kjconway5/ML-Audio/src/rtl/CIC/README.md

## CIC Deciamator

Since the PDM microphone will be outputting
a high-frequency 1-bit stream and our pro-
posed design will require a 16-bit output at
a sampling rate of 16kHz. We must convert
the pulse-density modulation into pulse-code
modulation(the standard form of digital audio
in hardware). This can be done by reducing the
sampling rate(decimation) and increasing the
word length, the preferred method to do this
is a Cascaded Integrator Comb Filter.
The filter consists of an equal number of in-
tegrator and comb filters alongside a decimator.
This describes a single stage CIC filter, however
we can improve attenuation by increasing the
stages of integrators and comb filters.
For this design we choose the number of
stages to be N = 3, this provides a good spot.
We can analyze this decision by looking at the
z-domain transfer function of
the CIC Filter:\
&emsp; &emsp; $H(z) = [(1-z^(-R)/(1-z^(-1))]^N$

In these equations $M = 1$ and $R = \frac{f_{in}}{f_{out}}$. Additionally,
upon analyzing these equations in MATLAB we
find that the outputted frequencies will have
less gain as the frequencies increases: 

Sized Image

This in turn will cause the higher frequencies bins on
a spectrogram(input to ML model) to be low
and potentially cause issues for ML speech
detection, this is called pass-band droop. To
combat this we can employ compensation FIR
Filters since ”in typical decimation filtering ap-
plication we desire reasonably flat pass band
gain and narrow transition region width per-
formance”.

### IP Usage
This CIC Filter is designed, tested, copyrighted by Alex Forencich.
