kjconway5/ML-Audio/src/rtl/Log-Mel/scripts/mel_filterbank.png

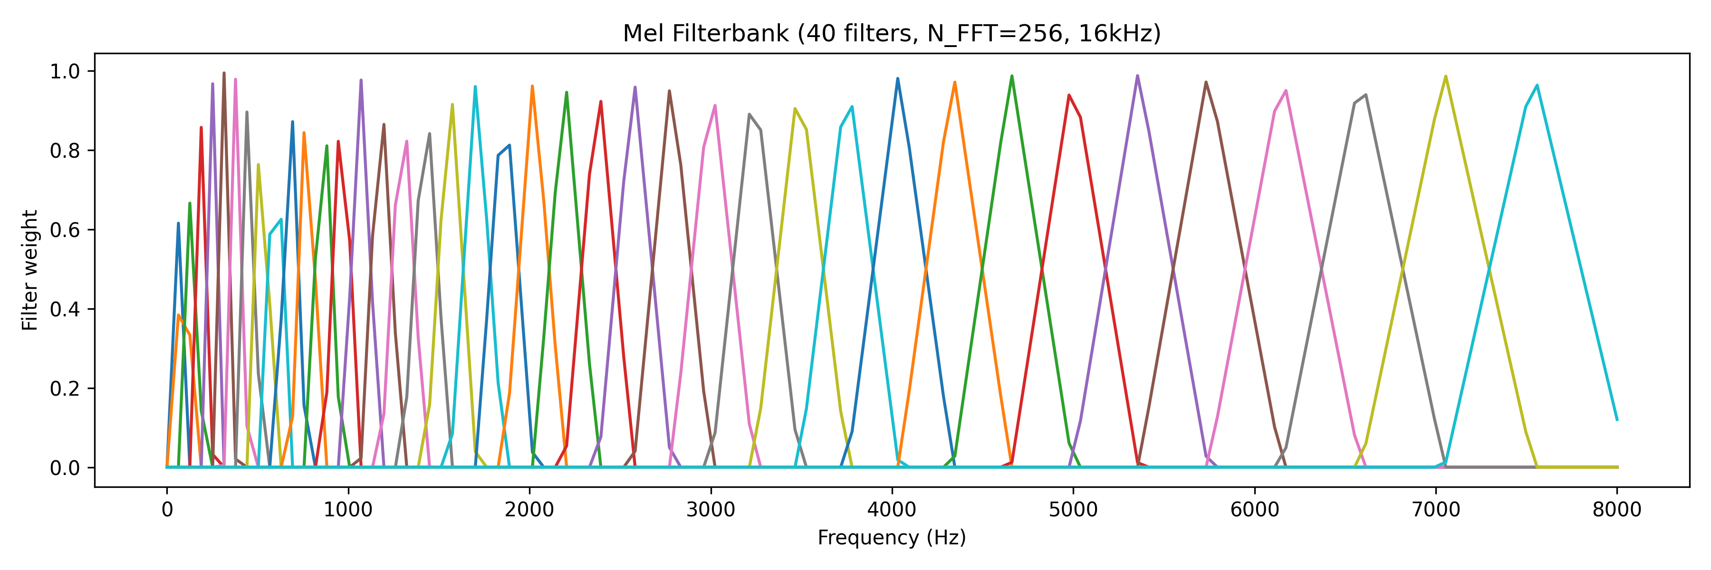
src/rtl/Log-Mel/scripts/mel_filterbank.png
