kjconway5/ML-Audio/src/ml/models/dscnn-16full-v1/sim-core-results.txt

[2026-05-18 14:13:56 PDT] make sim-core
Model: dscnn-16full-v1
Filters: 16
Manifest: /home/dnocera/ML-Audio/src/rtl/dscnn/kws_top/spectrograms/test_vectors.json
Selected sample[9]: f736ab63_nohash_4.wav
WAV: /home/dnocera/ML-Audio/src/ml/Pipeline/speech_commands_v0.02/yes/f736ab63_nohash_4.wav
Hex: spectrograms/spectrogram_9.hex
Golden truth class: yes (6)
Arithmetic class: yes (6)
PyTorch class: yes (6)
RTL class: yes (6)
Expected[manifest arithmetic]: yes (6)
Result: PASS
RTL GAP scores: no(0)=494  off(1)=-789  on(2)=-2415  silence(3)=-2190  unknown(4)=747  wow(5)=150  yes(6)=2204
RTL GAP ranking: yes(6)=2204 > unknown(4)=747 > no(0)=494 > wow(5)=150 > off(1)=-789 > silence(3)=-2190 > on(2)=-2415  margin=1457
