kjconway5/ML-Audio/src/rtl/STFFT/R2FFT/test/1024pt_16bit/result.ods

# vsim work.testbench -c
# Start time: 23:56:48 on Nov 01 | 2016
# Loading sv_std.std
# Loading work.testbench
# Loading work.R2FFT
# Loading work.bitReverseCounter
# Loading work.bfp_bitWidthDetector
# Loading work.bfp_maxBitWidth
# Loading work.bfp_bitWidthAcc
# Loading work.fftAddressGenerator
# Loading work.butterflyUnit
# Loading work.twiddleFactorRomBridge
# Loading work.butterflyCore
# Loading work.bfp_Shifter
# Loading work.ramPipelineBridge
# Loading work.radix2Butterfly
# Loading work.readBusMux
# Loading work.writeBusMux
# Loading work.twrom
# Loading work.dpram
# | input data
# | real part | imag part
# | 0 | 0
# | 1607 | 0
# | 3211 | 0
# | 4808 | 0
# | 6392 | 0
# | 7961 | 0
# | 9512 | 0
# | 11039 | 0
# | 12539 | 0
# | 14010 | 0
# | 15446 | 0
# | 16846 | 0
# | 18204 | 0
# | 19519 | 0
# | 20787 | 0
# | 22005 | 0
# | 23170 | 0
# | 24279 | 0
# | 25330 | 0
# | 26319 | 0
# | 27245 | 0
# | 28106 | 0
# | 28898 | 0
# | 29621 | 0
# | 30273 | 0
# | 30852 | 0
# | 31357 | 0
# | 31785 | 0
# | 32138 | 0
# | 32413 | 0
# | 32610 | 0
# | 32728 | 0
# | 32767 | 0
# | 32728 | 0
# | 32610 | 0
# | 32413 | 0
# | 32138 | 0
# | 31785 | 0
# | 31357 | 0
# | 30852 | 0
# | 30273 | 0
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
