kjconway5/ML-Audio/src/rtl/STFFT/R2FFT/test/256pt_8bit/result.ods

# vsim work.testbench -c
# Start time: 23:53:50 on Nov 01 | 2016
# Loading sv_std.std
# Loading work.testbench
# Loading work.R2FFT
# Loading work.bitReverseCounter
# Loading work.bfp_bitWidthDetector
# Loading work.bfp_maxBitWidth
# Loading work.bfp_bitWidthAcc
# Loading work.fftAddressGenerator
# Loading work.butterflyUnit
# Loading work.twiddleFactorRomBridge
# Loading work.butterflyCore
# Loading work.bfp_Shifter
# Loading work.ramPipelineBridge
# Loading work.radix2Butterfly
# Loading work.readBusMux
# Loading work.writeBusMux
# Loading work.twrom
# Loading work.dpram
# | input data
# | real part | imag part
# | 0 | 0
# | 24 | 0
# | 48 | 0
# | 71 | 0
# | 90 | 0
# | 106 | 0
# | 118 | 0
# | 125 | 0
# | 127 | 0
# | 125 | 0
# | 118 | 0
# | 106 | 0
# | 90 | 0
# | 71 | 0
# | 48 | 0
# | 24 | 0
# | 0 | 0
# | -25 | 0
# | -49 | 0
# | -72 | 0
# | -91 | 0
# | -107 | 0
# | -119 | 0
# | -126 | 0
# | -128 | 0
# | -126 | 0
# | -119 | 0
# | -107 | 0
# | -91 | 0
# | -72 | 0
# | -49 | 0
# | -25 | 0
# | -1 | 0
# | 24 | 0
# | 48 | 0
# | 71 | 0
# | 90 | 0
# | 106 | 0
# | 118 | 0
# | 125 | 0
# | 127 | 0
# | 125 | 0
# | 118 | 0
# | 106 | 0
# | 90 | 0
# | 71 | 0
# | 48 | 0
# | 24 | 0
# | 0 | 0
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
