kjconway5/ML-Audio/src/rtl/STFFT/R2FFT/test/4096pt_24bit/result.ods

# vsim work.testbench -c
# Start time: 23:49:17 on Nov 01 | 2016
# Loading sv_std.std
# Loading work.testbench
# Loading work.R2FFT
# Loading work.bitReverseCounter
# Loading work.bfp_bitWidthDetector
# Loading work.bfp_maxBitWidth
# Loading work.bfp_bitWidthAcc
# Loading work.fftAddressGenerator
# Loading work.butterflyUnit
# Loading work.twiddleFactorRomBridge
# Loading work.butterflyCore
# Loading work.bfp_Shifter
# Loading work.ramPipelineBridge
# Loading work.radix2Butterfly
# Loading work.readBusMux
# Loading work.writeBusMux
# Loading work.twrom
# Loading work.dpram
# | input data
# | real part | imag part
# | 0 | 0
# | 102941 | 0
# | 205866 | 0
# | 308761 | 0
# | 411609 | 0
# | 514395 | 0
# | 617104 | 0
# | 719720 | 0
# | 822227 | 0
# | 924610 | 0
# | 1026855 | 0
# | 1128944 | 0
# | 1230864 | 0
# | 1332598 | 0
# | 1434132 | 0
# | 1535449 | 0
# | 1636536 | 0
# | 1737376 | 0
# | 1837954 | 0
# | 1938255 | 0
# | 2038265 | 0
# | 2137968 | 0
# | 2237348 | 0
# | 2336392 | 0
# | 2435084 | 0
# | 2533409 | 0
# | 2631353 | 0
# | 2728900 | 0
# | 2826036 | 0
# | 2922747 | 0
# | 3019018 | 0
# | 3114834 | 0
# | 3210181 | 0
# | 3305044 | 0
# | 3399410 | 0
# | 3493264 | 0
# | 3586592 | 0
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
