kjconway5/ML-Audio/src/rtl/STFFT/R2FFT/test/ifft/result.ods

# vsim work.testbench -c
# Start time: 23:59:39 on Nov 01 | 2016
# Loading sv_std.std
# Loading work.testbench
# Loading work.R2FFT
# Loading work.bitReverseCounter
# Loading work.bfp_bitWidthDetector
# Loading work.bfp_maxBitWidth
# Loading work.bfp_bitWidthAcc
# Loading work.fftAddressGenerator
# Loading work.butterflyUnit
# Loading work.twiddleFactorRomBridge
# Loading work.butterflyCore
# Loading work.bfp_Shifter
# Loading work.ramPipelineBridge
# Loading work.radix2Butterfly
# Loading work.readBusMux
# Loading work.writeBusMux
# Loading work.twrom
# Loading work.dpram
# | input data
# | real part | imag part
# | 13107 | 0
# | 16034 | -63
# | 18719 | -125
# | 21065 | -188
# | 22985 | -250
# | 24403 | -313
# | 25257 | -375
# | 25501 | -438
# | 25107 | -500
# | 24066 | -563
# | 22390 | -625
# | 20108 | -688
# | 17271 | -750
# | 13944 | -813
# | 10210 | -875
# | 6164 | -937
# | 1911 | -1000
# | -2435 | -1062
# | -6760 | -1125
# | -10947 | -1187
# | -14884 | -1250
# | -18466 | -1312
# | -21599 | -1375
# | -24201 | -1437
# | -26207 | -1500
# | -27568 | -1562
# | -28257 | -1625
# | -28264 | -1687
# | -27600 | -1749
# | -26297 | -1812
# | -24404 | -1874
# | -21987 | -1937
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
