kjconway5/ML-Audio/src/rtl/STFFT/R2FFT/test/small_signal/result.ods

# vsim -voptargs="+acc" work.testbench -c
# Start time: 19:08:45 on Nov 02 | 2016
# Loading sv_std.std
# Loading work.testbench
# Loading work.R2FFT
# Loading work.bitReverseCounter
# Loading work.bfp_bitWidthDetector
# Loading work.bfp_maxBitWidth
# Loading work.bfp_bitWidthAcc
# Loading work.fftAddressGenerator
# Loading work.butterflyUnit
# Loading work.twiddleFactorRomBridge
# Loading work.butterflyCore
# Loading work.bfp_Shifter
# Loading work.ramPipelineBridge
# Loading work.radix2Butterfly
# Loading work.readBusMux
# Loading work.writeBusMux
# Loading work.twrom
# Loading work.dpram
# | input data
# | real part | imag part
# | 3 | 0
# | 4 | 0
# | 1 | 0
# | -3 | 0
# | -5 | 0
# | -3 | 0
# | -1 | 0
# | 0 | 0
# | 0 | 0
# | 2 | 0
# | 4 | 0
# | 2 | 0
# | -2 | 0
# | -5 | 0
# | -4 | 0
# | -1 | 0
# | -1 | 0
# | 0 | 0
# | 1 | 0
# | 3 | 0
# | 3 | 0
# | -1 | 0
# | -4 | 0
# | -4 | 0
# | -2 | 0
# | -1 | 0
# | 0 | 0
# | 1 | 0
# | 3 | 0
# | 4 | 0
# | 1 | 0
# | -3 | 0
# | -5 | 0
# | -3 | 0
# | -1 | 0
# | 0 | 0
# | 0 | 0
# | 2 | 0
# | 4 | 0
# | 2 | 0
# | -2 | 0
# | -5 | 0
# | -4 | 0
# | -1 | 0
# | -1 | 0
# | 0 | 0
# | 1 | 0
# | 4 | 0
# | 3 | 0
# | -1 | 0
# | -4 | 0
# | -4 | 0
# | -2 | 0
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
