kjconway5/ML-Audio/src/rtl/STFFT/R2FFT/test/triple_buffering/result.ods

# vsim work.testbench -c
# Start time: 20:52:23 on Nov 15 | 2016
# Loading sv_std.std
# Loading work.testbench
# Loading work.R2FFT_tribuf
# Loading work.bitReverseCounter
# Loading work.bfp_bitWidthDetector
# Loading work.bfp_maxBitWidth
# Loading work.bfp_bitWidthAcc
# Loading work.fftAddressGenerator
# Loading work.butterflyUnit
# Loading work.twiddleFactorRomBridge
# Loading work.butterflyCore
# Loading work.bfp_Shifter
# Loading work.ramPipelineBridge
# Loading work.radix2Butterfly
# Loading work.readBusMux_tribuf
# Loading work.readBusMux
# Loading work.writeBusMux_tribuf
# Loading work.writeBusMux
# Loading work.twrom
# Loading work.dpram
#
# | FFT Result
# | real part | imag part | ampl | 1st frame | 2nd frame | 3rd frame | 4th frame | 5th frame
# | -1024 | 0 | 1024 | 1024 | 1024 | 1024 | 768 | 512
# | 0 | 0 | 0 | 0 | 0 | 0 | 362.038672 | 0
# | -512 | -512 | 724.077344 | 724.077344 | 0 | 724.077344 | 362.038672 | 286.216701
# | 0 | 0 | 0 | 0 | 0 | 0 | 256 | 0
# | 0 | 0 | 0 | 0 | 724.077344 | 0 | 256 | 0
# | 0 | 0 | 0 | 0 | 0 | 0 | 256 | 0
# | -512 | -512 | 724.077344 | 724.077344 | 0 | 1024 | 0 | 181.019336
# | 0 | 0 | 0 | 0 | 0 | 0 | 256 | 0
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
