kjconway5/ML-Audio/src/rtl/top/full_pipeline_top.sv

module full_pipeline_top #(

    // CIC decimator params
    parameter int CIC_IN_W   = 16,
    parameter int CIC_STAGES = 3,
    parameter int CIC_M      = 1,
    parameter int CIC_RMAX   = 63,
    // Internal accumulator: 16 + ceil(log2(63^3)) = 16 + 18 = 34 bits
    parameter int CIC_REG_W  = CIC_IN_W + $clog2((CIC_RMAX * CIC_M) ** CIC_STAGES),

    // FIR compensation filter params  (runs at 16 kHz)
    parameter int FIR_NTAPS  = 33,
    parameter int FIR_IW     = 18,
    parameter int FIR_CW     = 14,
    parameter int FIR_OW     = 2 * FIR_IW + 5,  // = 37 (full headroom)

    // STFFT params  (16 kHz, 16-bit in / 16-bit per rail out)
    parameter int IW_STFFT   = 16,
    parameter int OW_STFFT   = 16,
    parameter int FFT_SIZE   = 256,
    parameter int FFT_N      = $clog2(FFT_SIZE),
    parameter int HOP        = FFT_SIZE / 2,
    parameter int FIFO_DEPTH = 64,
    parameter FIFO_AW        = $clog2(FIFO_DEPTH),
    parameter int BFP_Q_FRAC = 10,

    // LogMel params
    parameter int IW_LOGMEL  = OW_STFFT,                        // 16
    parameter int SHIFT      = 6,
    parameter int N_MELS     = 40,
    parameter int N_BINS     = 129,
    parameter int MAX_COEFFS = 16,
    parameter int POWER_W    = 2 * IW_LOGMEL - SHIFT + 1 - 1,  // 25
    parameter int WEIGHT_W   = 16,
    parameter int ACCUM_W    = 54,
    parameter int LOG_OUT_W  = 16,
    parameter int LUT_FRAC   = 6,
    parameter int OUT_W      = 16,

    // Spectrogram buffer params
    parameter int SPECT_SHIFT = 9,
    parameter int USE_INPUT_REQUANT = 1,
    parameter int INPUT_QUANT_MULT  = 5805163,
    parameter int INPUT_QUANT_SHIFT = 31,
    parameter int START_FRAME = 37,
    parameter int N_FRAMES    = 50,
    parameter int ADDR_W      = 11
) (
    input  logic clk_i,
    input  logic reset_i,

    // Audio input — 1.008 MHz, 16-bit signed PCM
    input  logic signed [15:0] data_i,
    input  logic               valid_i,
    output logic               ready_o,


    // Spectrogram SRAM ports
    output wire                sp_a_we,
    output wire [ADDR_W-1:0]   sp_a_waddr,
    output wire signed [7:0]   sp_a_wdata,

    output wire                sp_b_we,
    output wire [ADDR_W-1:0]   sp_b_waddr,
    output wire signed [7:0]   sp_b_wdata,

    output logic               spect_done,
    output logic               spect_write_sel,

    output logic [OUT_W-1:0]   mel_compensated_o,
    output logic               mel_compensated_valid_o,

    // VAD threshold (from boot controller)
    input  logic [31:0]        vad_threshold_i,

    // VAD status (active high when speech detected)
    output logic               vad_active_o,

    // DFT / Frame drop
    input  logic                dft_vad_obs_en_i,
    output logic                vad_frame_drop_ol,

    // Flash-load ports for LogMel SRAMs
    input  logic                 flash_mel_coeff_we_i,
    input  logic [7:0]           flash_mel_coeff_addr_i,
    input  logic [15:0]          flash_mel_coeff_data_i,

    input  logic                 flash_mel_index_we_i,
    input  logic [7:0]           flash_mel_index_addr_i,
    input  logic [7:0]           flash_mel_index_data_i,

    input  logic                 flash_log_lut_we_i,
    input  logic [LUT_FRAC-1:0]  flash_log_lut_addr_i,
    input  logic [LOG_OUT_W-1:0] flash_log_lut_data_i,

    // test signals 
    input  logic                   test_mode_audio,

        // cic 
    output logic [CIC_REG_W-1:0]     cic_audio,

        // fir 
    output logic signed [FIR_OW-1:0]    FIR_audio_in,
    output logic signed [FIR_OW-1:0]    FIR_audio_out,

        // spect buff
    output logic [ADDR_W-1:0]      sp_a_waddr_test,
    output logic signed [7:0]      sp_a_wdata_test,

    output logic [ADDR_W-1:0]      sp_b_waddr_test,
    output logic signed [7:0]      sp_b_wdata_test,
    output logic                   spect_write_sel_test,

        // logmel 
    input  logic [7:0]          test_coeff_addr_i,
    input  logic [7:0]          test_index_addr_i,
    input  logic [LUT_FRAC-1:0] test_lut_addr_i,

    output logic [1:0] frame_control_state, 
    output logic [$clog2(N_MELS)-1:0] mel_idx_test,
    output logic [POWER_W:0] power_test


);

// 1.  CIC Decimator — 1.008 MHz → 16 kHz  (ratio 63, 3 stages, M=1)
logic                       stfft_i_ready;  

logic [CIC_REG_W-1:0]  cic_data;   // 34-bit internal accumulator value
logic                  cic_valid;
logic                  cic_ready;
logic                  fir_ready_o;

cic_decimator #(
    .WIDTH    (CIC_IN_W),   // 16
    .RMAX     (CIC_RMAX),   // 63
    .M        (CIC_M),      // 1
    .N        (CIC_STAGES), // 3
    .REG_WIDTH(CIC_REG_W)   // 34
) u_cic (
    .clk           (clk_i),
    .rst           (reset_i),
    .input_tdata   (data_i),
    .input_tvalid  (valid_i),
    .input_tready  (ready_o),
    .output_tdata  (cic_data),
    .output_tvalid (cic_valid),
    .output_tready (fir_ready_o),
    .rate          ($clog2(CIC_RMAX+1)'(CIC_RMAX)),

    // test output 
    .cic_audio     (cic_audio)
);


// 2.  CIC output 

logic signed [15:0] cic_trunc;
logic               cic_trunc_valid;

assign cic_trunc = (cic_data + (1 << 17)) >>> 18; // NOT PARAMITIZED TODO
assign cic_trunc_valid = cic_valid;


// 3.  FIR Compensation Filter

logic [FIR_OW-1:0] fir_result;   // 37-bit full-precision output
logic              fir_valid_o;
logic              fir_ready_i;


compFIR #(
    .NTAPS     (FIR_NTAPS), // 14
    .IW        (FIR_IW),    // 18
    .CW        (FIR_CW),    // 16
    .OW        (FIR_OW)    // 37
) u_fir (
    .i_clk    (clk_i),
    .i_reset  (reset_i),
    .i_tdata  (cic_trunc),
    .i_tvalid (cic_valid),
    .i_tready (fir_ready_o),      
    .o_tdata  (fir_result),
    .o_tvalid (fir_valid_o),
    .o_tready (stfft_i_ready),       

    .FIR_audio_in (FIR_audio_in),
    .FIR_audio_out(FIR_audio_out)
);


// 4.  FIR output 

logic signed [15:0] fir_trunc;
logic               fir_trunc_valid;

assign fir_trunc = (fir_result + (1 << 14)) >>> 15; // NOT PARAMITIZED TODO
assign fir_trunc_valid = fir_valid_o;


// 5.  STFFT — 16 kHz, 16-bit signed input, 32-bit output {re[15:0],im[15:0]}

logic                       stfft_o_valid;
logic [2*OW_STFFT-1:0]      stfft_o_data;
logic                       stfft_o_last;
logic signed [7:0]          bfpexp_raw;

stfft #(
    .IW      (IW_STFFT),
    .OW      (OW_STFFT),
    .FFT_SIZE(FFT_SIZE),
    .HOP     (HOP)
) u_stfft (
    .i_clk    (clk_i),
    .i_reset  (reset_i),

    .i_valid  (fir_valid_o),
    .i_data   (fir_trunc),
    .i_ready  (stfft_i_ready),

    .o_valid  (stfft_o_valid),
    .o_data   (stfft_o_data),
    .o_ready  (1'b1),               // never backpressure the FFT output
    .o_last   (stfft_o_last),
    .o_bfpexp (bfpexp_raw)
);


logic stfft_o_valid_d;
always_ff @(posedge clk_i) begin
    if (reset_i)
        stfft_o_valid_d <= 1'b0;
    else
        stfft_o_valid_d <= stfft_o_valid;
end

// 1-cycle pulse on the FIRST cycle of each frame's output stream.
wire fft_sync_pulse = stfft_o_valid && !stfft_o_valid_d;

// 2. FFT output pipeline registers + 2-cycle delayed sync

logic                       fft_valid_r,  fft_valid_rr;
logic [2*OW_STFFT-1:0]      fft_result_r, fft_result_rr;
logic                       fft_sync_r,   fft_sync_rr;

always_ff @(posedge clk_i) begin
    if (reset_i) begin
        fft_valid_r   <= 1'b0;
        fft_valid_rr  <= 1'b0;
        fft_result_r  <= '0;
        fft_result_rr <= '0;
        fft_sync_r    <= 1'b0;
        fft_sync_rr   <= 1'b0;
    end else begin
        fft_valid_r   <= stfft_o_valid;
        fft_valid_rr  <= fft_valid_r;
        fft_result_r  <= stfft_o_data;
        fft_result_rr <= fft_result_r;
        fft_sync_r    <= fft_sync_pulse;
        fft_sync_rr   <= fft_sync_r;
    end
end

logic signed [OW_STFFT-1:0] fft_re, fft_im;
assign fft_re = fft_result_rr[2*OW_STFFT-1 : OW_STFFT];
assign fft_im = fft_result_rr[OW_STFFT-1   : 0];


// 4. Bin counter — gate fft_valid to the first N_BINS cycles of each frame
//
// bin_cnt_q loads on fft_sync_r (one cycle before fft_result_rr latches
// bin 0), so fft_valid is high for exactly the 129 cycles when bins
// 0..128 sit on fft_result_rr.


localparam int CNT_W = $clog2(N_BINS + 1);
logic [CNT_W-1:0] bin_cnt_q;

always_ff @(posedge clk_i) begin
    if (reset_i)
        bin_cnt_q <= '0;
    else if (fft_sync_r)
        bin_cnt_q <= CNT_W'(N_BINS);
    else if (bin_cnt_q > 0)
        bin_cnt_q <= bin_cnt_q - 1'b1;
end

logic fft_valid;
assign fft_valid = (bin_cnt_q > 0);


// 4. bfpexp latch  (also driven by aligned sync so it updates on the same
//    cycle logmel starts consuming the new frame)

logic signed [7:0] bfpexp_for_mel;

always_ff @(posedge clk_i) begin
    if (reset_i)
        bfpexp_for_mel <= '0;
    else if (fft_sync_r)
        bfpexp_for_mel <= bfpexp_raw;
end

// 5. LogMel (with new VAD port)
logic vad_active;

logic [OUT_W-1:0] mel_data;
logic             mel_valid;
logic             mel_ready;

logmel_top #(
    .IW        (IW_LOGMEL),
    .SHIFT     (SHIFT),
    .N_MELS    (N_MELS),
    .N_BINS    (N_BINS),
    .MAX_COEFFS(MAX_COEFFS),
    .POWER_W   (POWER_W),
    .WEIGHT_W  (WEIGHT_W),
    .ACCUM_W   (ACCUM_W),
    .LOG_OUT_W (LOG_OUT_W),
    .LUT_FRAC  (LUT_FRAC),
    .OUT_W     (OUT_W)
) u_logmel (
    .clk_i                  (clk_i),
    .reset_i                (reset_i),
    .re_il                  (fft_re),
    .im_il                  (fft_im),
    .fft_valid_il           (fft_valid),
    .fft_sync_il            (fft_sync_r),
    .cnn_data_ol            (mel_data),
    .cnn_valid_ol           (mel_valid),
    .cnn_ready_il           (mel_ready),
    .flash_mel_coeff_we_i   (flash_mel_coeff_we_i),
    .flash_mel_coeff_addr_i (flash_mel_coeff_addr_i),
    .flash_mel_coeff_data_i (flash_mel_coeff_data_i),
    .flash_mel_index_we_i   (flash_mel_index_we_i),
    .flash_mel_index_addr_i (flash_mel_index_addr_i),
    .flash_mel_index_data_i (flash_mel_index_data_i),
    .flash_log_lut_we_i     (flash_log_lut_we_i),
    .flash_log_lut_addr_i   (flash_log_lut_addr_i),
    .flash_log_lut_data_i   (flash_log_lut_data_i),
    .vad_threshold_il       (vad_threshold_i),
    .vad_active_ol          (vad_active),
    .dft_vad_obs_en_i       (dft_vad_obs_en_i),
    .vad_frame_drop_ol      (vad_frame_drop_ol),

    // test mode
    .test_mode_i(test_mode_audio),
    .test_coeff_addr_i(test_coeff_addr_i),  
    .test_index_addr_i(test_index_addr_i),
    .test_lut_addr_i(test_lut_addr_i), 
    .mel_idx_test(mel_idx_test),
    .power_test(power_test),
    .frame_control_state(frame_control_state)
);

assign vad_active_o = vad_active;



// 6. bfpexp compensation

localparam int CORR_W = OUT_W + 10;

logic signed [CORR_W-1:0] bfp_correction;
assign bfp_correction = ($signed(bfpexp_for_mel) <<< 1) * (1 << BFP_Q_FRAC);

logic signed [CORR_W-1:0] mel_compensated_wide;
assign mel_compensated_wide = $signed({{(CORR_W-OUT_W){1'b0}}, mel_data})
                            + bfp_correction;

logic [OUT_W-1:0] mel_compensated;
always_comb begin
    if (mel_compensated_wide < 0)
        mel_compensated = '0;
    else if (mel_compensated_wide >= (1 << OUT_W))
        mel_compensated = {OUT_W{1'b1}};
    else
        mel_compensated = mel_compensated_wide[OUT_W-1:0];
end

assign mel_compensated_o       = mel_compensated;
assign mel_compensated_valid_o = mel_valid;


// 7. Spectrogram buffer

spect_buffer_ctrl #(
    .SPECT_SHIFT      (SPECT_SHIFT),
    .USE_INPUT_REQUANT(USE_INPUT_REQUANT),
    .INPUT_QUANT_MULT (INPUT_QUANT_MULT),
    .INPUT_QUANT_SHIFT(INPUT_QUANT_SHIFT),
    .START_FRAME      (START_FRAME),
    .N_MELS           (N_MELS),
    .N_FRAMES         (N_FRAMES),
    .IN_W             (OUT_W),
    .ADDR_W           (ADDR_W)
) u_spect_buf (
    .clk            (clk_i),
    .reset          (reset_i),
    .cnn_data_i     (mel_compensated),
    .cnn_valid_i    (mel_valid),
    .cnn_ready_o    (mel_ready),
    .sp_a_we        (sp_a_we),
    .sp_a_waddr     (sp_a_waddr),
    .sp_a_wdata     (sp_a_wdata),
    .sp_b_we        (sp_b_we),
    .sp_b_waddr     (sp_b_waddr),
    .sp_b_wdata     (sp_b_wdata),
    .spect_done     (spect_done),
    .spect_write_sel(spect_write_sel),

    // test signals 
    .sp_a_waddr_test(sp_a_waddr_test),
    .sp_a_wdata_test(sp_a_wdata_test),
    .sp_b_waddr_test(sp_b_waddr_test),
    .sp_b_wdata_test(sp_b_wdata_test),
    .spect_write_sel_test(spect_write_sel_test),
    .test_mode_audio(test_mode_audio)
);

endmodule
