kjconway5/ML-Audio/src/rtl/CIC/cic.sv

/*

Copyright (c) 2015 Alex Forencich

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
*/

// Language: Verilog 2001

`timescale 1ns / 1ps

/*
 * Cascaded integrator-comb (CIC) Decimator
 */
module cic_decimator #(
    parameter WIDTH = 16,
    parameter RMAX = 2,
    parameter M = 1,
    parameter N = 2,
    parameter REG_WIDTH = WIDTH+$clog2((RMAX*M)**N)
)
(
    input  wire                      clk,
    input  wire                      rst,

    /*
     * AXI stream input
     */
    input  wire [WIDTH-1:0]          input_tdata,
    input  wire                      input_tvalid,
    output wire                      input_tready,

    /*
     * AXI stream output
     */
    output wire [REG_WIDTH-1:0]      output_tdata,
    output wire                      output_tvalid,
    input  wire                      output_tready,

    input logic                      test_mode_audio,
    output logic [REG_WIDTH-1:0]     cic_audio,

    /*
     * Configuration
     */
    input  wire [$clog2(RMAX+1)-1:0] rate
);

/*
 * CIC decimator architecture
 *
 *                       ,---.
 * IN -->(+)--------+--->| V |----+------->(-)--- OUT
 *        ^         |    `---'    |         ^
 *        |         |             |         |
 *        +-- z-1 --+             +-- z-M --+
 *
 *       \___________/           \___________/
 *             N                       N
 *
 *         Integrate    Decimate     Comb
 *
 */

reg [$clog2(RMAX+1)-1:0] cycle_reg = 0;

reg [REG_WIDTH-1:0] int_reg[N-1:0];

wire [REG_WIDTH-1:0] int_reg_0 = int_reg[0];
wire [REG_WIDTH-1:0] int_reg_1 = int_reg[1];

reg [REG_WIDTH-1:0] comb_reg[N-1:0];

wire [REG_WIDTH-1:0] comb_reg_0 = comb_reg[0];
wire [REG_WIDTH-1:0] comb_reg_1 = comb_reg[1];

assign input_tready = output_tready | (cycle_reg != 0);

assign output_tdata = comb_reg[N-1];
assign output_tvalid = input_tvalid & cycle_reg == 0;

genvar k;
// integer i;

// initial begin
//     for (i = 0; i < N; i = i + 1) begin
//         int_reg[i] <= 0;
//         comb_reg[i] <= 0;
//     end
// end

// integrator stages
generate

for (k = 0; k < N; k = k + 1) begin : integrator
    always @(posedge clk) begin
        if (rst) begin
            int_reg[k] <= 0;
        end else begin
            if (input_tready & input_tvalid) begin
                if (k == 0) begin
                    int_reg[k] <= $signed(int_reg[k]) + $signed(input_tdata);
                end else begin
                    int_reg[k] <= $signed(int_reg[k]) + $signed(int_reg[k-1]);
                end
            end
        end
    end
end

endgenerate

// comb stages
generate

for (k = 0; k < N; k = k + 1) begin : comb
    reg [REG_WIDTH-1:0] delay_reg[M-1:0];

    // initial begin
    //     for (i = 0; i < M; i = i + 1) begin
    //         delay_reg[i] <= 0;
    //     end
    // end

    always @(posedge clk) begin
        integer i;
        if (rst) begin
            for (i = 0; i < M; i = i + 1) begin
                delay_reg[i] <= 0;
            end
            comb_reg[k] <= 0;
        end else begin
            if (output_tready & output_tvalid) begin
                if (k == 0) begin
                    delay_reg[0] <= $signed(int_reg[N-1]);
                    comb_reg[k] <= $signed(int_reg[N-1]) - $signed(delay_reg[M-1]);
                end else begin
                    delay_reg[0] <= $signed(comb_reg[k-1]);
                    comb_reg[k] <= $signed(comb_reg[k-1]) - $signed(delay_reg[M-1]);
                end

                for (i = 0; i < M-1; i = i + 1) begin
                    delay_reg[i+1] <= delay_reg[i];
                end
            end
        end
    end
end

endgenerate

always @(posedge clk) begin
    if (rst) begin
        cycle_reg <= 0;
    end else begin
        if (input_tready & input_tvalid) begin
            if (cycle_reg < RMAX - 1 && cycle_reg < rate - 1) begin
                cycle_reg <= cycle_reg + 1;
            end else begin
                cycle_reg <= 0;
            end
        end
    end
end

// test mode to observe at io pins
always_ff @(posedge clk) begin
    if (rst) begin
        cic_audio <= 0;
    end else if (test_mode_audio) begin
        cic_audio <= output_tdata;
    end else begin
        cic_audio <= 0;
    end
end

endmodule
