kjconway5/ML-Audio/src/rtl/dscnn/weight_sram/weight_sram.sv

// Weight storage with write port for Subservient and read port for FSM: 6,752 x 8-bit INT8 values
// Implemented as 7x cascaded gf180mcu_ocd_ip_sram__sram1024x8m8wm1 macros
// (7 x 1024 = 7168)

module weight_sram #(
    parameter DEPTH  = 2352,
    parameter DATA_W = 8,
    parameter ADDR_W = 13   // covers 0-8191; valid range 0-6751
)(
    input  wire              clk,
    input  wire              reset,           // synchronous, active-high

    // Write port
    input  wire              we,              // write enable (1 = write, 0 = read)
    input  wire [ADDR_W-1:0] waddr,           
    input  wire [DATA_W-1:0] wdata,           // write data from SERV

    // Read port
    input  wire [ADDR_W-1:0] raddr,
    output wire [DATA_W-1:0] rdata
);

`ifdef SIM

    // Behavioral model for simulation
    reg [DATA_W-1:0] mem [0:DEPTH-1];

    reg [ADDR_W-1:0] raddr_q;
    always @(posedge clk) begin
        if (we)
            mem[waddr] <= wdata;
        if (reset)
            raddr_q <= '0;
        else
            raddr_q <= raddr;
    end

    assign rdata = mem[raddr_q];

`else

    localparam NUM_BANKS = 3;

    wire [ADDR_W-1:0] active_addr = we ? waddr : raddr;

    wire [2:0]  bank_sel  = active_addr[12:10];  
    wire [9:0]  bank_addr = active_addr[9:0];     

    // Per-bank chip enables
    wire [NUM_BANKS-1:0] cen;  // one per macro
    genvar gi;
    generate
        for (gi = 0; gi < NUM_BANKS; gi++) begin : gen_cen
            assign cen[gi] = (bank_sel == gi[2:0]) ? 1'b0 : 1'b1;     // Enable one bank for reading 
        end
    endgenerate

    wire [7:0] q_out [NUM_BANKS-1:0];     // Array of output buses 

    generate
        for (gi = 0; gi < NUM_BANKS; gi++) begin : gen_weight_banks
            gf180mcu_ocd_ip_sram__sram1024x8m8wm1 inst_weight_sram (
                .CLK  (clk),
                .CEN  (cen[gi]),
                .GWEN (~(we & ~cen[gi])), // only enable write on selected bank 
                .WEN  (8'h00),
                .A    (bank_addr),
                .D    (wdata),
                .Q    (q_out[gi])
                //`ifdef USE_POWER_PINS
                //, .VDD  (1'b1)
                //, .VSS  (1'b0)
                //`endif
            );
        end
    endgenerate

    // Account for 1 cycle read latency 
    reg [2:0] bank_sel_q;
    always_ff @(posedge clk)
        if (reset)
            bank_sel_q <= '0;
        else
            bank_sel_q <= bank_sel;

    assign rdata = q_out[bank_sel_q];

`endif

endmodule
