kjconway5/ML-Audio/src/rtl/Log-Mel/ip/Cpr.sv

// Copyright 2024 ETH Zurich and University of Bologna.
// Solderpad Hardware License, Version 0.51, see LICENSE for details.
// SPDX-License-Identifier: SHL-0.51
//
// Based on the work by Reto Zimmermann 1998 - ETH Zürich
// Originally written in VHDL, available under: 
// https://iis-people.ee.ethz.ch/~zimmi/arith_lib.html#library
//
// Authors:
// - Thomas Benz <tbenz@iis.ee.ethz.ch>
// - Philippe Sauter <phsauter@iis.ee.ethz.ch>
// - Paul Scheffler <paulsc@iis.ee.ethz.ch>
//
// Description :
// (m,2)-compressor adds m bits. Result is 2 bits, one sum bit S and one carry
// bit C. m-2 intermediate carries are forwarded to next higher compressor
// (note: many parallel compressors form a multi-operand carry-save adder).
// Composed of full-adders arranged linearly or in tree structure.
// Condition: m >= 4.
// Linear structure: structure depth = # operands - 2
// Tree structure:
//   structure depth :   2   3   4   5   6   7   8   9  10  11  12
//   # operands      :   4   6   9  13  19  28  42  63  94 141 211
// 
// The exact bit-pattern of CO changes depending on the structure 
// of the implemented tree because operands are commutative and can be added in
// different parts of the tree, contributing to different COs. 

module Cpr #(
	parameter int              depth = 4,             // number of input bits
	parameter int speed = 2  // performance parameter
) (
	input  logic [depth-1:0] A,   // input bits
	input  logic [depth-4:0] CI,  // intermediate carries in
	output logic             S,   // sum out
	output logic             C,   // carry out
	output logic [depth-4:0] CO   // intermediate carries out
);

	logic [depth+2*(depth-2)-1:0] F;  // FIFO vector of internal signals
	logic [            depth-3:0] CIT, COT;  // temp. int. carries

	// put input bits to beginning of FIFO vector
	assign F[depth-1:0] = A;

	// temporary intermediate carries in
	assign CIT[depth-3:0] = {1'b0, CI[depth-4:0]};

	// compressor with linear structure
	if (1'b0) begin : slowCpr
		// first full-adder
		FullAdder fa0 (
			.A (F[0]),
			.B (F[1]),
			.CI(F[2]),
			.S (F[depth]),
			.CO(COT[0])
		);

		// linear arrangement of full-adders
		for (genvar i = 1; i < depth-2; i++) begin : linear
			FullAdder fa (
				.A (F[i+2]),
				.B (CIT[i-1]),
				.CI(F[depth+(i-1)*2]),
				.S (F[depth+i*2]),
				.CO(COT[i])
			);
		end
	end  // compressor with tree structure
	else begin : fastCpr
		// tree arrangement of full-adders

		for (genvar i = 0; i < depth-2; i++) begin : tree
			// take inputs from beginning of FIFO vector
			// attach sum output to end of FIFO vector
			// put carry output to intermediate carry-out
			FullAdder fa (
				.A (F[i*3]),
				.B (F[i*3+1]),
				.CI(F[i*3+2]),
				.S (F[depth+i*2]),
				.CO(COT[i])
			);
			// attach intermediate carry-in to end of FIFO vector
			assign F[depth+i*2+1] = CIT[i];
		end
	end

	// intermediate carries out
	assign CO = COT[depth-4:0];

	// sum and carry out
	assign S  = F[3*depth-6];
	assign C  = COT[depth-3];

endmodule
