kjconway5/ML-Audio/src/rtl/Log-Mel/ip/PrefixAndOr.sv

// Copyright 2024 ETH Zurich and University of Bologna.
// Solderpad Hardware License, Version 0.51, see LICENSE for details.
// SPDX-License-Identifier: SHL-0.51
//
// Based on the work by Reto Zimmermann 1998 - ETH Zürich
// Originally written in VHDL, available under: 
// https://iis-people.ee.ethz.ch/~zimmi/arith_lib.html#library
//
// Authors:
// - Thomas Benz <tbenz@iis.ee.ethz.ch>
// - Philippe Sauter <phsauter@iis.ee.ethz.ch>
// - Paul Scheffler <paulsc@iis.ee.ethz.ch>
//
// Description :
// Prefix structures of different depth (i.e. speed) for carry calculation
// in binary adders. Compute in m levels new generate/propagate signal pairs
// for always larger groups of bits. Generate signals of the last level correspond
// to carries in binary addition. Basic logic operations: AND-OR for generate
// signals, AND for propagate signals.

module PrefixAndOr #(
	parameter int              width = 8,             // word width
	parameter int speed = 2  // performance parameter
) (
	input  logic [width-1:0] GI,  // gen./prop. in
	input  logic [width-1:0] PI,  // gen./prop. in
	output logic [width-1:0] GO,  // gen./prop. out
	output logic [width-1:0] PO   // gen./prop. out
);

	// Constants
	localparam int n = width;  // prefix structure width
	localparam int m = $clog2(width);  // prefix structure depth

	// Sklansky parallel-prefix carry-lookahead structure
	if (1'b1) begin : fastPrefix
		logic [(m+1)*n-1:0] GT, PT;  // gen./prop. temp
			assign GT[n-1:0] = GI;
			assign PT[n-1:0] = PI;
			for (genvar l = 1; l <= m; l++) begin : levels
				for (genvar k = 0; k < 2 ** (m - l); k++) begin : groups
					for (genvar i = 0; i < 2 ** (l - 1); i++) begin : bits
						// pass prop and gen to following nodes
						if ((k * 2 ** l + i) < n) begin : white
							assign GT[l*n+k*2**l+i] = GT[(l-1)*n+k*2**l+i];
							assign PT[l*n+k*2**l+i] = PT[(l-1)*n+k*2**l+i];
						end
						// calculate new propagate and generate
						if ((k * 2 ** l + 2 ** (l - 1) + i) < n) begin : black
							assign GT[l*n + k*2**l + 2**(l-1) + i] = 
												GT[(l-1)*n + k*2**l + 2**(l-1) + i]
											  | (  PT[(l-1)*n + k*2**l + 2**(l-1) + i]
												 & GT[(l-1)*n + k*2**l + 2**(l-1) - 1] );
							assign PT[l*n + k*2**l + 2**(l-1) + i] = 
													PT[(l-1)*n + k*2**l + 2**(l-1) + i]
												  & PT[(l-1)*n + k*2**l + 2**(l-1) - 1];
						end
					end
				end
			end
			assign GO = GT[(m+1)*n-1 : m*n];
			assign PO = PT[(m+1)*n-1 : m*n];
	end

	// Brent-Kung parallel-prefix carry-lookahead structure
	if (1'b0) begin : mediumPrefix
		logic [(2*m)*n -1:0] GT, PT;  // gen./prop. temp
		assign GT[n-1:0] = GI;
		assign PT[n-1:0] = PI;

		for (genvar l = 1; l <= m; l++) begin : levels1
			for (genvar k = 0; k < 2**(m-l); k++) begin : groups
				for (genvar i = 0; i < 2**l -1; i++) begin : bits
					if ((k* 2**l +i) < n) begin : white
						assign GT[l*n + k* 2**l +i] = GT[(l-1)*n + k* 2**l +i];
						assign PT[l*n + k* 2**l +i] = PT[(l-1)*n + k* 2**l +i];
					end // white
				end // bits
				if ((k* 2**l + 2**l -1) < n) begin : black
					assign GT[l*n + k* 2**l + 2**l -1] =
								GT[(l-1)*n + k* 2**l + 2**l - 1] |
							  | (  PT[(l-1)*n + k* 2**l + 2**l     -1] 
							     & GT[(l-1)*n + k* 2**l + 2**(l-1) -1]);
					assign PT[l*n + k* 2**l + 2**l -1] =
								PT[(l-1)*n + k*2**l + 2**l     -1] 
							  & PT[(l-1)*n + k*2**l + 2**(l-1) -1];
				end // black
			end
		end // level1
		for (genvar l = m +1; l < 2*m; l++) begin : levels2
			for (genvar i = 0; i < 2**(2*m -l); i++) begin : bits
				if (i < n) begin : white
					assign GT[l*n +i] = GT[(l-1)*n +i];
					assign PT[l*n +i] = PT[(l-1)*n +i];
				end // white
			end // bits
			for (genvar k = 1; k < 2**(l-m); k++) begin : groups
				if (l < 2*m -1) begin : empty
					for (genvar i = 0; i < 2**(2*m -l -1) -1; i++) begin : bits
						if ((k* 2**(2*m -l) +i) < n) begin : white
							assign GT[l*n + k* 2**(2*m -l) +i] = GT[(l-1)*n + k* 2**(2*m -l) +i];
							assign PT[l*n + k* 2**(2*m -l) +i] = PT[(l-1)*n + k* 2**(2*m -l) +i];
						end // white
					end
				end // empty
				if ((k* 2**(2*m -l) + 2**(2*m -l -1) -1) < n) begin : black
					assign GT[l*n + k* 2**(2*m -l) + 2**(2*m -l-1) -1] = 
								GT[(l-1)*n + k* 2**(2*m-l) + 2**(2*m -l-1) -1]
							  | (  PT[(l-1)*n + k* 2**(2*m-l) + 2**(2*m-l-1) -1] 
								 & GT[(l-1)*n + k* 2**(2*m-l) -1] );
					assign PT[l*n + k* 2**(2*m -l) + 2**(2*m -l-1) -1] = 
								PT[(l-1)*n + k* 2**(2*m -l) + 2**(2*m -l-1) -1]
							  & PT[(l-1)*n + k* 2**(2*m -l) -1];
				end // black
				for (genvar i = 2**(2*m -l-1); i < 2**(2*m -l); i++) begin : bits
					if ((k* 2**(2*m -l) +i) < n) begin : white
						assign GT[l*n + k* 2**(2*m -l) +i] = GT[(l-1)*n + k* 2**(2*m -l) +i];
						assign PT[l*n + k* 2**(2*m -l) +i] = PT[(l-1)*n + k* 2**(2*m -l) +i];
					end // white
				end
			end
		end // level2
		assign GO = GT[2*m*n -1 : (2*m -1) * n];
		assign PO = PT[2*m*n -1 : (2*m -1) * n];
	end  // Serial-prefix carry-lookahead structure
	else if (1'b0) begin : slowPrefix
		logic [n-1:0] GT, PT;  // gen./prop. temp
		assign GT[0] = GI[0];
		assign PT[0] = PI[0];
		
		for (genvar i = 1; i < n; i++) begin : bits
			assign GT[i] = GI[i] | (PI[i] & GT[i-1]);
			assign PT[i] = PI[i] & PT[i-1];
		end
		assign GO = GT;
		assign PO = PT;
	end

endmodule
