kjconway5/ML-Audio/src/rtl/Log-Mel/rtl/log_top/test_logmel_top.py

import os
import cocotb
from cocotb.clock import Clock
from cocotb.triggers import RisingEdge, ClockCycles
import numpy as np
import torchaudio.transforms as T
from pathlib import Path

IW            = 18
SHIFT         = 6
N_MELS        = 40
N_BINS        = 129
POWER_W       = 31
WEIGHT_W      = 16
ACCUM_W       = 54
LOG_OUT_W     = 16
LUT_FRAC      = 6
Q_FRAC        = 10
CLK_PERIOD_NS = 10

SAMPLE_RATE = 16000
N_FFT       = 256
WIN_LENGTH  = 256
F_MIN       = 0.0
F_MAX       = SAMPLE_RATE / 2.0

IW_MASK    = (1 << IW)      - 1
POWER_MASK = (1 << POWER_W) - 1
ACCUM_MASK = (1 << ACCUM_W) - 1
WEIGHT_MAX = (1 << WEIGHT_W) - 1

MAX_LOG_INT = (1 << (LOG_OUT_W - Q_FRAC)) - 1  # 63 for Q6.10

# Data directory
DATA_DIR = Path(__file__).resolve().parent / ".." / ".." / "data"

# log2 fractional LUT (Q6.10)
with open(DATA_DIR / "log2_lut.hex") as _f:
    LOG2_LUT = [int(line.strip(), 16) for line in _f if line.strip()]

LOG_TOLERANCE = 2


# ----------------------------------------------------------------
# Reference Model
# ----------------------------------------------------------------

class LogMelRef:

    def __init__(self, vad_threshold=0):
        self.vad_threshold = vad_threshold
        self._build_filterbank()

    def _build_filterbank(self):
        mel_t = T.MelSpectrogram(
            sample_rate=SAMPLE_RATE,
            n_fft=N_FFT,
            win_length=WIN_LENGTH,
            hop_length=128,
            n_mels=N_MELS,
            f_min=F_MIN,
            f_max=F_MAX,
            power=2.0,
        )
        fb_float = mel_t.mel_scale.fb.numpy()
        fb_fixed = np.round(fb_float * (2 ** 15)).astype(np.int64)
        self.fb  = np.clip(fb_fixed, 0, WEIGHT_MAX)

    def _power(self, re: np.ndarray, im: np.ndarray) -> np.ndarray:
        re_s = re.astype(np.int64)
        im_s = im.astype(np.int64)
        half = 1 << (IW - 1)
        re_s = np.where(re_s >= half, re_s - (1 << IW), re_s)
        im_s = np.where(im_s >= half, im_s - (1 << IW), im_s)
        real_sq  = (re_s ** 2).astype(np.uint64)
        imag_sq  = (im_s ** 2).astype(np.uint64)
        sum_full = real_sq + imag_sq
        return ((sum_full >> SHIFT) & POWER_MASK).astype(np.uint64)

    def _filterbank(self, power: np.ndarray) -> np.ndarray:
        p     = power.astype(np.int64)
        accum = p @ self.fb
        return (accum & ACCUM_MASK).astype(np.uint64)

    def _log_one(self, energy: int) -> int:
        if energy == 0:
            return 0
        log2_int = int(energy).bit_length() - 1
        if log2_int > MAX_LOG_INT:
            return (1 << LOG_OUT_W) - 1  # saturation
        mask = (1 << LUT_FRAC) - 1
        if log2_int >= LUT_FRAC:
            addr = (energy >> (log2_int - LUT_FRAC)) & mask
        else:
            addr = (energy << (LUT_FRAC - log2_int)) & mask
        result = (log2_int << Q_FRAC) + LOG2_LUT[addr]
        return result & ((1 << LOG_OUT_W) - 1)

    def is_voiced(self, power: np.ndarray) -> bool:
        energy = int(np.sum(power.astype(np.uint64)))
        energy = min(energy, (1 << 32) - 1)
        return energy > self.vad_threshold
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
