kjconway5/ML-Audio/(commit log)

2026-01-20 mostly done with frame
2026-01-30 initial python filters, stft, and logmel
2026-02-10 Update model configuration and training setup
    Expanded model from 3 to 6 classes (no, yes, stop, go, happy, unknown), increased training epochs to 200, and switched audio processing to use soundfile for Docker compatibility. Updated model weights accordingly.
2026-02-10 Train 7-class model with silence and improve inference pipeline
    - Retrained model with 7 classes (added silence class)
    - Changed n_fft to 256 for better performance
    - Reduced epochs to 100 (achieved 93.70% test accuracy)
    - Added window_length parameter to SimplePipeline for consistency
    - Fixed test_live_audio.py to correctly read config from checkpoint
    - Fixed default n_classes in model.py to 6
    Model results:
    - Best validation accuracy: 94.57%
    - Final test accuracy: 93.70%
    [config.yaml]
2026-02-20 fixed lint warnings: unused pin and bit in convround & wn
    [stfft.sv]
2026-02-24 cleaned up a bunch of IP stuff for log-mel, power_calc tb added
2026-03-03 log_mel frame control verification written and passed
2026-03-03 Clean up Makefiles. Changed filterbank to compute one at a time. Finished Filterbank Testbench
2026-03-04 Add simulation and verification details to README, delete unused modules frame, HPF, and LPF
2026-04-02 Finished cnn/pipeline connection, chip_core needs pin connections
2026-04-05 Replaced 5V SRAM Macros w/ 3.3V Macros
    [feature_sram.sv, spectrogram_sram.sv, weight_sram.sv]
2026-04-05 Created git submodules for 5V PDK & Added submodule for 3.3V PDK/SRAM Macros
2026-04-06 small fix to mac_array, most teseting complete
    [mac_array.sv, test_mac_array.py]
2026-04-06 mac_array tested + fixed mac_array
    [mac_array.sv, test_mac_array.py]
2026-04-06 spect_buff syntax fix; reset test dont
    [spect_buffer_ctrl.sv, test_spect_buffer_ctrl.py]
2026-04-09 feat: vendor R2FFT HDL files
    [result.ods]
2026-04-11 New filterbank modules substituting SRAM macros for hex files (untested), look to condense coeffs to use less memory, rollback subservient testing files, keep submodules in case
2026-04-16 Top_module boot_controller. Frames,parses and validates incoming bytes. Routes bytes to appropriate SRAMS
2026-04-16 cleaned up dir, added framing to stfft, new tests, twiddle case-statements
2026-04-16 migrate ZipCPU FFT to R2FFT with custom Hanning window and dual-port RAM
    - Replace ZIPCPU fftmain with R2FFT core
    - Implement direct Hanning window (3-stage pipeline, no windowfn dependency)
    - Behavioral dual-port fft_data_ram for simulation
    - Synthesized twiddle ROM (64 entries, Q1.15)
    - All 7 cocotb tests pass: SNR >60dB, correct bin locations, consecutive frames
    [fft.sv, fft_data_ram.sv, stfft.sv]
2026-04-17 fixing comments on RAM
    [fft_data_ram.sv]
2026-04-20 added back pytest compatibility for filterbank, filterbank now verified, uses 2 1024 and 2 256 SRAMs, will try to condense now
2026-04-20 Verified filterbank with sparse coefficient data, updated FSM, start/end bin indices now in one SRAM and file along with filter offsets.
    Went from 2 1024 and 2 256 SRAMs (2.56 kb) to 3 256 SRAMs (.768 kb) total
2026-04-20 Updated log_lut to use the 3.3V macros instead of 5V. Changed from 4.12 to 6.10 because saturation was being reached too easily, updated log_lut data to match, and updated testbench for log_lut simul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
2026-04-20 Updated logmel top level to work with new loadable filterbank and log_lut modules and changed to 6.10. Added pytest testbench for log_top to get waveform, log_lut and log_top should now be verified w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
2026-04-20 Updated pipeline and chip top levels with new loadable filterbank and added ports where necessary, next is testing top level
2026-04-21 fixed merged conflict issues
    [pipeline_top.sv]
2026-04-21 fixed cocotb test to work for fft twice as fast as log mel
    [pipeline_top.sv, test_pipeline_top.py]
2026-04-21 updated golden model and fixed 50% overlap on STFFT
    [compare_outputs.py, fft.sv, pipeline_top.sv, stfft.sv, test_pipeline_top.py]
2026-04-21 RLT requant bug fix - DSCNN RTL freeze
    [requant.sv]
2026-04-22 filterbank test working now, passing
2026-04-22 trying to resolve merge
    [test_pipeline_top.py]
2026-04-22 rtl tests fixed after model change
    [test_FSM.py, test_mac_array.py, test_requant.py, test_spectrogram_sram.py]
2026-04-23 clean up legacy files, new FIR, full_pipeline_top -> FIR handshake not working
    [fft.sv, full_pipeline_top.sv, pipeline_top.sv, stfft.sv]
2026-04-27 fix output buffer testbench, all good now
    [test_output_buffer.py]
2026-04-27 added test mode compatibility to filterbank files, changed all instantiations and updated tbs and retested, all good
2026-04-27 Revert "updated test to includes wav files and deleted hex"
    This reverts commit 532e3833101725dc1f4d1c607a47b1ff69228d46.
    [test_full_pipeline_top.py]
2026-04-27 Restore dscnn-32requant-v11 from RTL requant fix commit
    [config.yaml]
2026-04-28 fixed file paths compare_wav_outputs.py
    [compare_wav_outputs.py]
2026-04-28 Added SRAM macro placements (random locations right now just to get flow running), fixed linting errors in dscnn modules for power pins, fixed bit widhts in chip_core but chip_core still needs to be 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
    [config.yaml, feature_sram.sv, spectrogram_sram.sv, weight_sram.sv]
2026-04-29 fixed cic issue i think, synthesizes now, issue with SRAMs being optimized away
    [cic.sv, config.yaml]
2026-04-30 5V -> 3.3V 256x8 SRAM Conversion
2026-04-30 Updated makefile for 3v3 SRAM files, fixed SRAMs not being found issue by updating placeholder chip_core, now goes through synthesis and floorplan but fails with PDN issue, added config.tcl file from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
    [chip_core.sv, config.yaml, fft_data_ram.sv, log_lut_sram.sv, mel_coeff_sram.sv]
2026-05-01 fixed incorrect timing corners for 1024 srams
    [config.yaml]
2026-05-02 Adding dscnn-32center-v1 = Working model for end-end verification. And new 24 filter full model (better results than v1 but outdated)
2026-05-08 VAD implemented with threshold value register, updated boot_pkg and boot router, VAD module in Logmel dir, updated frame_ctrl, log_top and full pipeline for new vad ports, updated all testbenches, sc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
2026-05-11 updated vad model with autovad option, updated pipeline/logmel files with DFT vad ports for observing when a frame is dropped, VAD now has three modes, PASSTHROUGH (off), Hardcoded threshold, and 2 s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
    [chip_core.sv, chip_core_tb.py, full_pipeline_top.sv, logmel_top.sv, spectral_vad.sv, test_full_pipeline_top.py]
2026-05-13 Main with all 3 filter size Models verified
2026-05-14 syntax fixes post merge
    [FSM.sv, frame_control.sv]
2026-05-19 fixed incorrect comments and added rom into R2FFT to get FFT test working
    [R2FFT.sv, butterflyUnit.sv, fft.sv, stfft.sv]
2026-05-20 change config clock and uart prescalar to fit 16 mhz main clock
2026-05-21 changed hanning.hex into case-statement function, might change to submodule for easier hierarchy in librelane
2026-05-22 updated submodule for antenna tiedown issue, ran update_rtl for dscnn16-center but can be changed to any 16 filter model,fixed lint errors in stfft, updated floorplan, small config changes
    [chip_core.sv, chip_core_tb.py, config.yaml, feature_sram.sv, full_pipeline_top.sv, pipeline_top.sv, stfft.sv, test_feature_sram.py]
2026-05-22 new nix files for LVS_IGNORE error
    [config.yaml]
2026-05-22 reverted to old nix files for now, spread floor plan a bit, added some false paths, hold time violations are fixed, max cap and max slew violations reduced
    [config.yaml]
2026-05-24 hold time violatiosn fixed with way less buffers needed, cap violatiosn down from 900 to ~200, max slew vios down to 2 for STApostPNR
    [config.yaml]
2026-06-06 GL files
    [vdd.csv, vss.csv]
2026-06-09 3v3 library fix for newest flake file issues, latest config with updated floorplan, fixed incorrect port wiring issues
    [chip_core.sv, config.yaml, full_pipeline_top.sv]
2026-06-09 newest config, update nix shell before running, added back dft pin wires and connections that were accidentally reverted and caused errors in librelane flow, no cap or slew vios, small negative hold 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
    [chip_core.sv, config.yaml]
2026-06-10 fixed lvs issues, manufacturability report now good, trying to improve hold more and skew
    [config.yaml]
2026-06-10 docs: updated README.md to include fixed design steps, filter parameters, a verliog generation step, and testbench sectioon
    TODO: finish design step 5
2026-06-10 docs: added CIC Filter passband graph and CSD design section
2026-06-11 chore: rename frame_size(1).png to frame_size.png
2026-06-18 Snapshot: main state with passing GL+SDF sim (pre hold-time fixes)
    Captures the working-tree state of local main at e236a38 where the
    gate-level SDF simulation (chip_top_tb.test_chip_top_e2e) passes.
    Source files only; build artifacts (final/, tools/) excluded.
    [FSM.sv, bias_SRAM.sv, chip_top_sdf_wrapper.sv, chip_top_tb.py, feature_sram.sv, kws_top.sv]
2026-06-22 Resolve conflict for sim-top-results.txt
    [config.yaml]
2026-06-23 fix: timing violations have been resolved through floorplan adjustments and sram orientation tweaks
    [config.yaml]
2026-06-28 fix: updated flake files for new template version and fixed timing on this new version
    [config.yaml]
2026-07-08 template migration WIP, checkpoint before reverting slot YAML files
2026-07-09 fixed pdn issue, now testing github actions, some slew violations remaining on 3.0v corner
    [config.yaml]
2026-07-10 fix: LVS issues fixed, clean run done, checking github actions
    [config.yaml]
2026-07-13 fix: change chip_top_tb paths for git actions, add missing cell stubs
    [chip_top_tb.py, gf180mcu_fd_io.v]
